KN-NaMi/Nanopositioner/electronics/amplifier/simulation/amplifier.asc

C1: cap; 1.2n
R1: res; 10k
R2: res; 220
R3: res; 30k
R4: res; 10k
R5: res; 100k
U1: OPAx197
U2: OPAx197
U3: IL300
U4: UniversalOpAmp
V1: voltage; SINE(1.5V 1.5V 1k)
V2: voltage; 15V
V3: voltage; 15V
V4: voltage; 60V
V5: voltage; 30V
V6: voltage; -2.9V
Named nets: 0, -15V, +15V, -30V, +60V, VIN
.tran 30m
