KN-NaMi/Nanopositioner/electronics/PSU/Sim/MANIP_Charge_Pump_sym.asc

C1: cap; 10�
C2: cap; 10�
C3: cap; 10n
C4: cap; 10n
C5: cap; 1�
C6: cap; 10�
C7: cap; 10�
R1: res; 1.15Meg
R2: res; 100k
R3: res; 100k
R4: res; 1.15Meg
R5: res; 500r
R6: res; 500r
U1: LTC3260
V1: voltage; 24; Rser=5
Named nets: 0, 24V, +15V, -15V
f = 500khz
const f mode
LOAD
30mA per Rail
.tran 0 10m 0 startup
