KN-NaMi/Nanopositioner/electronics/PSU/Sim/MANIP_Flyback_sym.asc

205k: res; 180k
C1: cap; 10µ
C2: cap; 1µ
C3: cap; 1n
C4: cap; 10µ
C5: cap; 10µ
C7: cap; 1µ
C8: cap; 10µ
C9: cap; 1n
D1: diode; MBRS360
D2: diode; MBRS360
D3: zener; BZX84C15L
D4: zener; BZX84C15L
L1: ind; 9µ; Rser=85m
L2: ind; 144µ; Rser=370m
L3: ind; 9µ; Rser=85m
L4: ind; 36µ; Rser=370m
R1: res; 48k
R2: res; 680k
R3: res; 1.5k
R4: res; 48k
R5: res; 115k
R6: res; 10k
R7: res; 1.5k
R8: res; 500r
R9: res; 200r
R10: res; 40r
R11: res; 680k
R12: res; 150k
R13: res; 10k
R14: res; 115k
R15: res; 40r
U1: ADPL54203
U2: ADPL54203
V1: voltage; 24; Rser=1r
Named nets: 24V, 0, +15V, -15V, +60V, 0V, -30V
K1 L1 L2  1
P=0.45W (30mA)
P=1.35W (30mA)
LOAD
1:4
UVLO at 20V (1.214V)
.tran 0 2s 0 100n startup
150mA per rail
zener 15V
140k - 60V
180k - 75V
K2 L3 L4  1
1:2
UVLO at 20V (1.214V)
750313445
750313445
