KN-NaMi/Nanopositioner/electronics/amplifier/PCB/amplifier.kicad_pcb

## KiCad design electronics/amplifier/PCB/amplifier.kicad_pcb (2026-03-23)

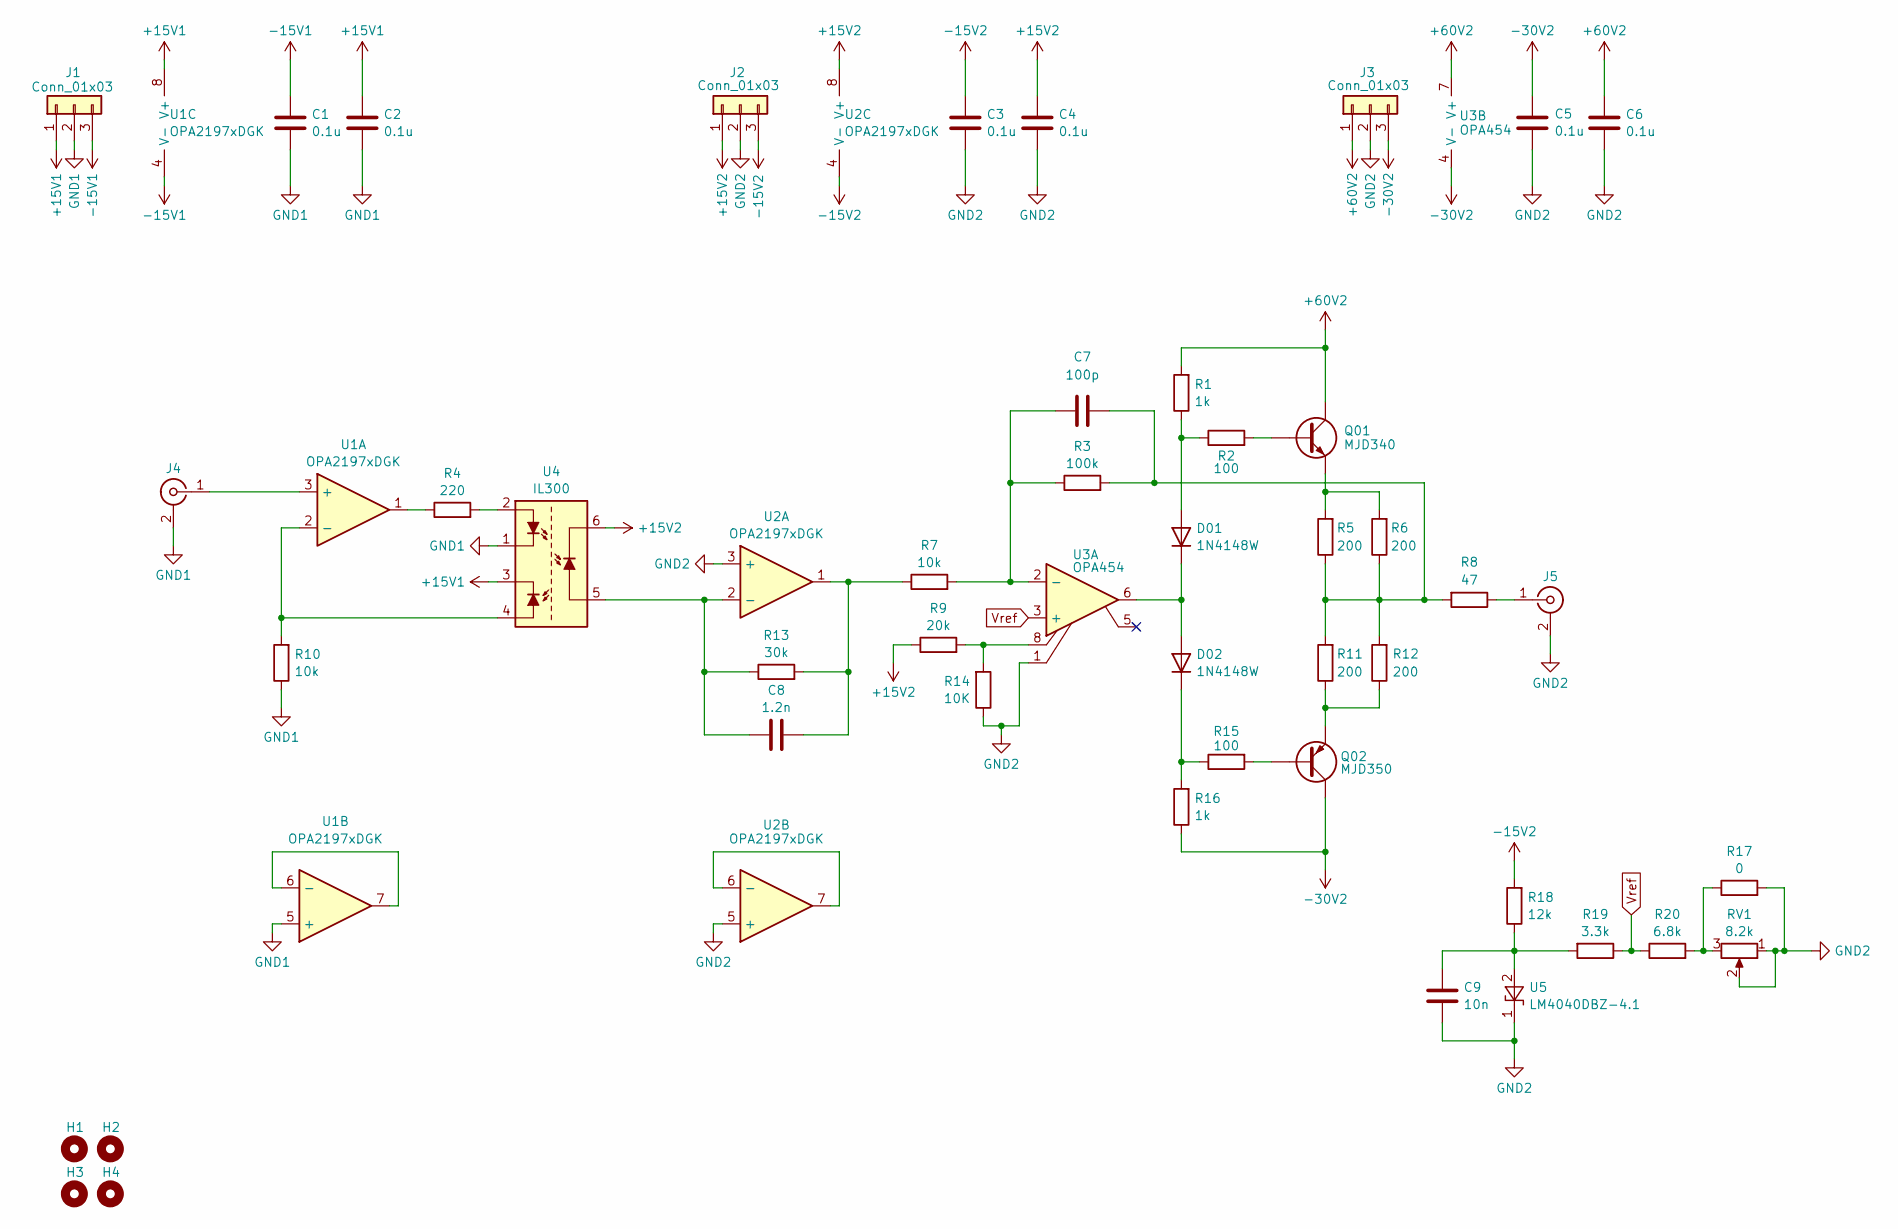
[picture p1: schematic amplifier.kicad_sch, Nanopositioner]

Parts:
C1, C2, C3, C4, C5: 0.1u; R_0603_1608Metric; Digikey 399-C0603C104K5RACTUCT-ND
C6: 0.1u; R_0603_1608Metric; Digikey 490-3285-1-ND
C7: 100p; C_0603_1608Metric; Digikey 3372-0603B101K101SDTR-ND
C8: 1.2n; C_0603_1608Metric; Digikey 490-1453-1-ND
C9: 10n; C_0603_1608Metric; Digikey 399-C0603C103K5RACTUCT-ND
D01, D02: 1N4148W; D_SOD-123; Digikey 1655-1N4148WCT-ND
H1, H2, H3, H4: MountingHole; MountingHole_3.2mm_M3_DIN965
J1, J2, J3: Conn_01x03; TerminalBlock_Phoenix_PT-1,5-3-5.0-H_1x03_P5.00mm_Horizontal; Digikey 732-10956-ND
J4, J5: Conn_Coaxial; SMA_Amphenol_132134_Vertical; Digikey 2073-RFPC-SMA28-F-ND
Q01: MJD340; TO-252-3_TabPin4; Digikey MJD340T4GOSCT-ND
Q02: MJD350; TO-252-3_TabPin4; Digikey MJD350T4GOSCT-ND
R1, R16: 1k; R_0603_1608Metric; Digikey 541-2788-1-ND
R2, R15: 100; R_0603_1608Metric; Digikey 541-2786-1-ND
R3: 100k; R_0805_2012Metric; Digikey 541-2850-1-ND
R4: 220; R_0603_1608Metric; Digikey 541-10437-1-ND
R5, R6, R11, R12: 200; R_2512_6332Metric; Digikey A116015CT-ND
R7, R10: 10k; R_0603_1608Metric; Digikey 541-2795-1-ND
R8: 47; R_2512_6332Metric; Digikey 118-CHP2512AFX-47R0ELFCT-ND
R9: 20k; R_0603_1608Metric; Digikey 541-2797-1-ND
R13: 30k; R_0603_1608Metric; Digikey 541-10453-1-ND
R14: 10K; R_0603_1608Metric; Digikey 541-2795-1-ND
R17: 0; R_0603_1608Metric
R18: 12k; R_0603_1608Metric; Digikey 541-10428-1-ND
R19: 3.3k; R_0603_1608Metric; Digikey 541-10464-1-ND
R20: 6.8k; R_0603_1608Metric; Digikey 541-10489-1-ND
RV1: 8.2k; Potentiometer_Vishay_T93YA_Vertical; Digikey 716-T63YA802KT20-ND
U1, U2: OPA2197xDGK; VSSOP-8_3x3mm_P0.65mm; Digikey 296-47349-1-ND
U3: OPA454; DDA0008J; Digikey 296-41370-1-ND
U4: IL300; SMDIP-8_W9.53mm_Clearance8mm; Digikey IL300-DEFG-X007-ND
U5: LM4040DBZ-4.1; SOT-23; Digikey LM4040AIM3-4.1/NOPBCT-ND

Connections:
+15V1: C2.1, J1.1, U1.8 (V+), U4.3
+15V2: C4.1, J2.1, R9.1, U2.8 (V+), U4.6
+60V2: C6.1, J3.1, Q01.C, R1.2, U3.7 (V+)
-15V1: C1.1, J1.3, U1.4 (V-)
-15V2: C3.1, J2.3, R18.2, U2.4 (V-)
-30V2: C5.1, J3.3, Q02.C, R16.1, U3.4 (V-)
GND1: C1.2, C2.2, J1.2, J4.2 (Ext), R10.1, U1.5 (+), U4.1
GND2: C3.2, C4.2, C5.2, C6.2, C9.1, J2.2, J3.2, J5.2 (Ext), R14.1, R17.2, RV1.1, RV1.2, U2.3 (+), U2.5 (+), U3.1, U5.1 (K)
unnamed: C7.2, R3.2, R5.1, R6.1, R8.2, R11.2, R12.2
unnamed: C8.2, R7.1, R13.2, U2.1
unnamed: D01.2 (A), R1.1, R2.1
unnamed: D01.1 (K), D02.2 (A), U3.6
unnamed: D02.1 (K), R15.1, R16.2
unnamed: J4.1 (In), U1.3 (+)
unnamed: J5.1 (In), R8.1
unnamed: Q01.B, R2.2
unnamed: Q01.E, R5.2, R6.2
unnamed: Q02.B, R15.2
unnamed: Q02.E, R11.1, R12.1
unnamed: R4.1, U1.1
unnamed: R4.2, U4.2
unnamed: R9.2, R14.2, U3.8
unnamed: R17.1, R20.2, RV1.3
unnamed: R10.2, U1.2 (-), U4.4
unnamed: U1.6 (-), U1.7
unnamed: C8.1, R13.1, U2.2 (-), U4.5
unnamed: U2.6 (-), U2.7
unnamed: C7.1, R3.1, R7.2, U3.2 (-)
unnamed: C9.2, R18.1, R19.2, U5.2 (A)
Vref: R19.1, R20.1, U3.3 (+)

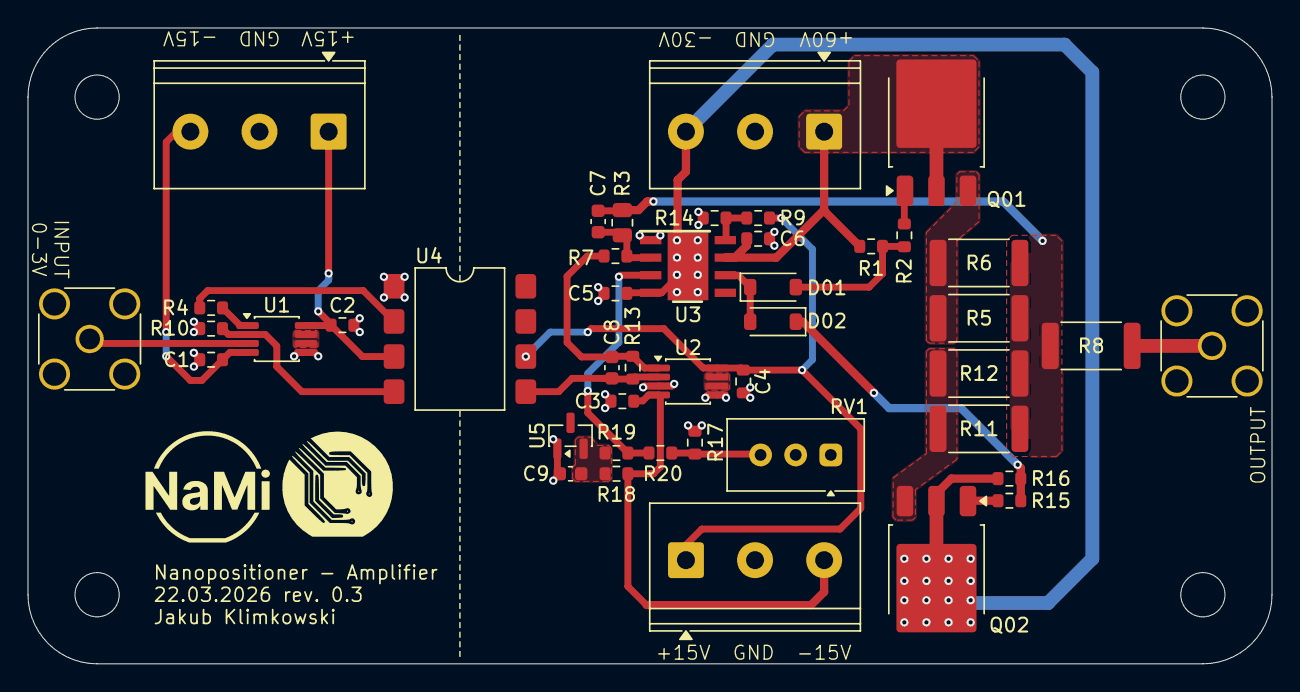
[picture p2: board amplifier.kicad_pcb from above]

Board: 2 copper layers, 90.0 x 46.0 mm, 48 parts (0 on the bottom side), 30 nets.
