KN-NaMi/Nanopositioner/electronics/PSU/pcb/psu.kicad_pcb

## KiCad design electronics/PSU/pcb/psu.kicad_pcb (2025-11-23)

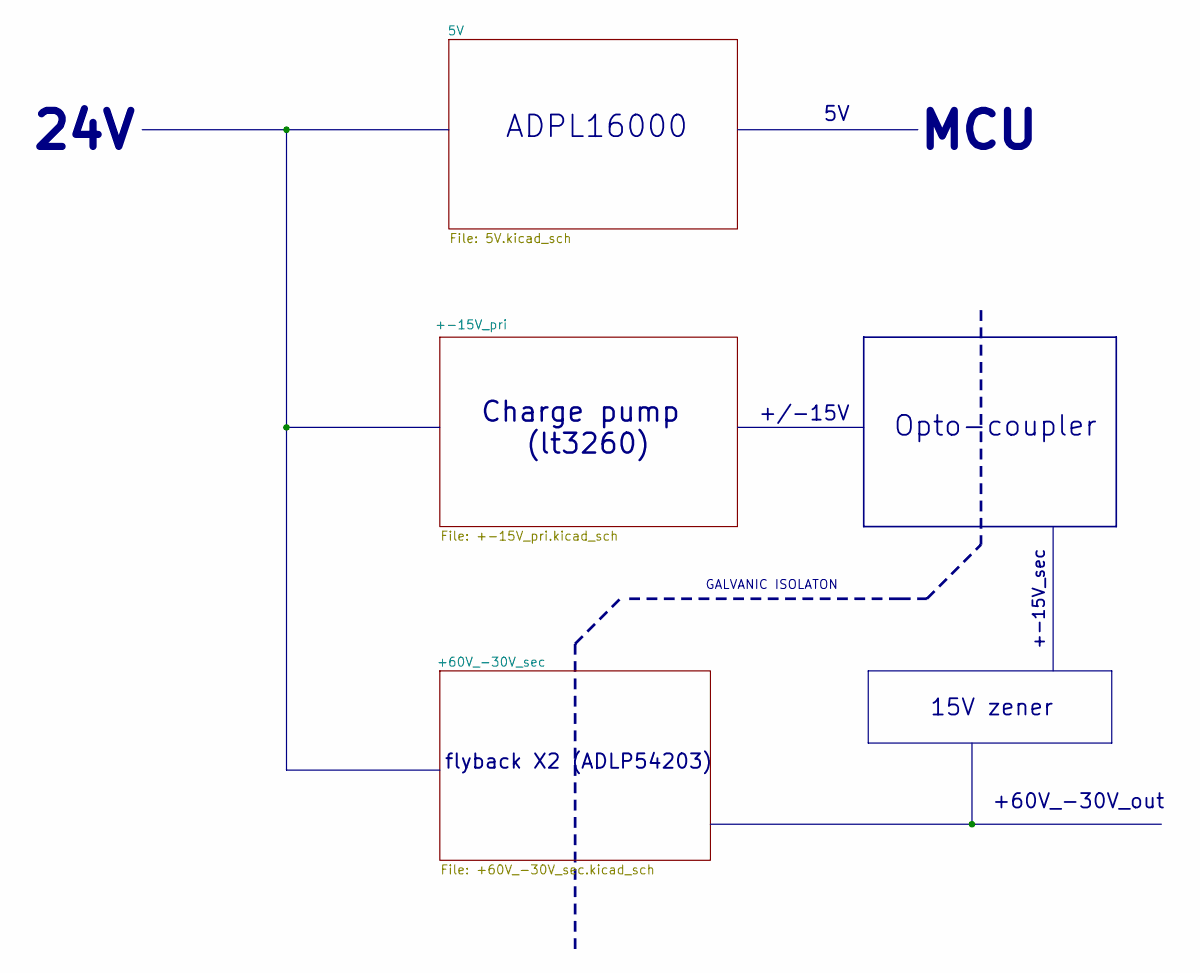
[picture p3: schematic psu.kicad_sch, MANIP_PSU]

Notes on the sheet:
MCU
+60V_-30V_out
flyback X2 (ADLP54203)
24V
ADPL16000
GALVANIC ISOLATON
+-15V_sec
+/-15V
Charge pump (lt3260)
15V zener
Opto-coupler

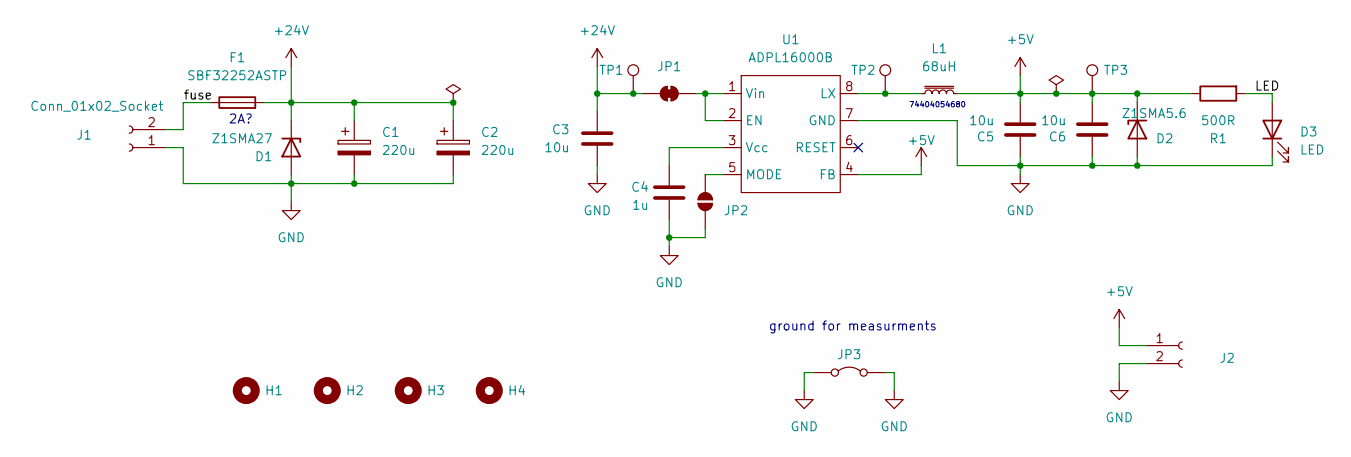
[picture p4: schematic 5V.kicad_sch, MANIP_PSU]

Parts:
C1, C2: 220u; CP_Radial_D8.0mm_P3.50mm
C3, C5, C6: 10u; C_0805_2012Metric
C4: 1u; C_0805_2012Metric
D1: Z1SMA27; D_SMA
D2: Z1SMA5.6; D_SMA
D3: LED; LED_0603_1608Metric
F1: SBF32252ASTP; Fuse_1206_3216Metric
H1, H2, H3, H4: MountingHole; MountingHole_4.3mm_M4_ISO14580
J1, J2: Conn_01x02_Socket; Wago_734-132_1x02_P3.50mm_Vertical
JP1: SolderJumper_2_Bridged; SolderJumper-2_P1.3mm_Bridged2Bar_RoundedPad1.0x1.5mm
JP2: SolderJumper_2_Open; SolderJumper-2_P1.3mm_Bridged_RoundedPad1.0x1.5mm
JP3: Jumper_2_Bridged; C_Axial_L12.0mm_D6.5mm_P20.00mm_Horizontal
L1: 68uH; L_Wuerth_MAPI-5030
R1: 500R; R_0805_2012Metric
TP1, TP2, TP3: TestPoint; TestPoint_Pad_D1.5mm
U1: ADPL16000B; ADPL16000footprint

Connections:
+5V: C5.2, C6.2, D2.1 (K), J2.1, L1.2, R1.1, TP3.1, U1.4 (FB)
+24V: C1.1, C2.1, C3.1, D1.1 (K), F1.2, JP1.1 (A), TP1.1; also elsewhere on the board
/5V/LED: D3.2 (A), R1.2
/5V/fuse: F1.1, J1.2
GND: C1.2, C2.2, C3.2, C4.2, C5.1, C6.1, D1.2 (A), D2.2 (A), D3.1 (K), J1.1, J2.2, JP2.1 (A), JP3.1 (A), JP3.2 (B), U1.7 (GND); also elsewhere on the board
unnamed: JP1.2 (B), U1.1 (Vin), U1.2 (EN)
unnamed: JP2.2 (B), U1.5 (MODE)
unnamed: L1.1, TP2.1, U1.8 (LX)
unnamed: C4.1, U1.3 (Vcc)

Notes on the sheet:
74404054680
2A?
ground for measurments

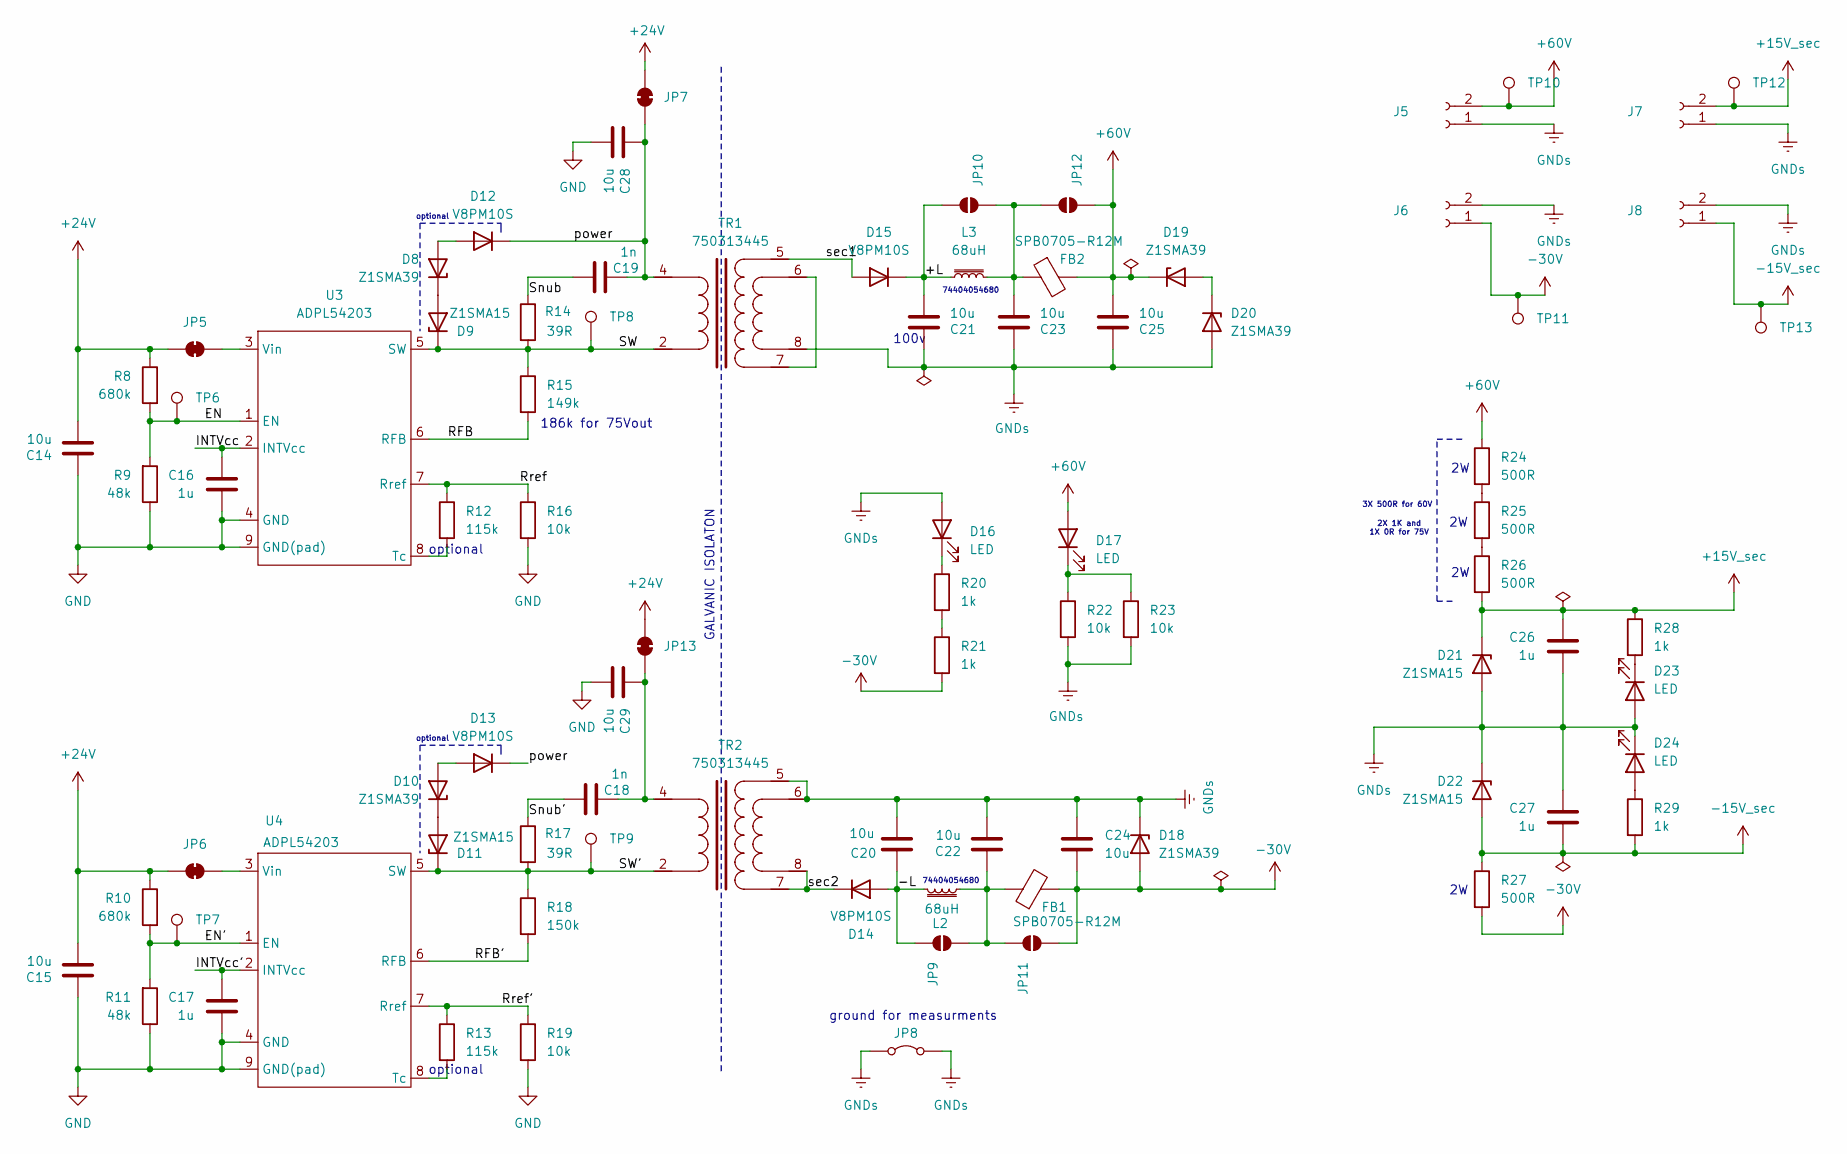
[picture p5: schematic +60V_-30V_sec.kicad_sch, MANIP_PSU]

Parts:
C14, C15, C20, C22, C24, C28, C29: 10u; C_0805_2012Metric
C16, C17, C26, C27: 1u; C_0805_2012Metric
C18, C19: 1n; C_0805_2012Metric
C21, C23, C25: 10u; C_1210_3225Metric
D8, D10, D18, D19, D20: Z1SMA39; D_SMA
D9, D11, D21, D22: Z1SMA15; D_SMA
D12, D13, D14, D15: V8PM10S; TO-277A
D16, D17, D23, D24: LED; LED_0603_1608Metric
FB1, FB2: SPB0705-R12M; L_Coilcraft_1515SQ-68N
J5, J6, J7, J8: Conn_01x02_Socket; Wago_734-132_1x02_P3.50mm_Vertical
JP5, JP6, JP7, JP13: SolderJumper_2_Bridged; SolderJumper-2_P1.3mm_Bridged2Bar_RoundedPad1.0x1.5mm
JP8: Jumper_2_Bridged; C_Axial_L12.0mm_D6.5mm_P15.00mm_Horizontal
JP9, JP10, JP11, JP12: SolderJumper_2_Open; SolderJumper-2_P1.3mm_Open_RoundedPad1.0x1.5mm
L2, L3: 68uH; L_Wuerth_MAPI-5030
R8, R10: 680k; R_0805_2012Metric
R9, R11: 48k; R_0805_2012Metric
R12, R13: 115k; R_0805_2012Metric
R14, R17: 39R; R_2512_6332Metric
R15: 149k; R_0805_2012Metric
R16, R19, R22, R23: 10k; R_0805_2012Metric
R18: 150k; R_0805_2012Metric
R20, R21, R28, R29: 1k; R_0805_2012Metric
R24, R25, R26, R27: 500R; R_2512_6332Metric
TP6, TP7, TP8, TP9, TP10, TP11, TP12, TP13: TestPoint; TestPoint_Pad_D1.5mm
TR1, TR2: 750313445
U3, U4: ADPL54203; SOIC-8-1EP_3.9x4.9mm_P1.27mm_EP2.514x3.2mm_ThermalVias

Connections:
+15V_sec: C26.1, D21.1 (K), J7.2, R26.2, R28.1, TP12.1
+24V: C14.2, C15.2, JP5.2 (B), JP6.2 (B), JP7.2 (B), JP13.1 (A), R8.1, R10.1; also elsewhere on the board
+60V: C25.2, D17.2 (A), D19.1 (K), FB2.2, J5.2, JP12.1 (A), R24.1, TP10.1
-15V_sec: C27.2, D22.2 (A), J8.1, R27.1, R29.2, TP13.1
-30V: C24.2, D18.2 (A), FB1.2, J6.1, JP11.2 (B), R21.2, R27.2, TP11.1
/+60V_-30V_sec/+L: C21.2, D15.3 (K), JP10.2 (B), L3.1
/+60V_-30V_sec/-L: C20.1, D14.1 (A), D14.2 (A), JP9.1 (A), L2.2
/+60V_-30V_sec/EN: R8.2, R9.2, TP6.1, U3.1 (EN)
/+60V_-30V_sec/EN': R10.2, R11.2, TP7.1, U4.1 (EN)
/+60V_-30V_sec/INTVcc: C16.1, U3.2 (INTVcc)
/+60V_-30V_sec/INTVcc': C17.1, U4.2 (INTVcc)
/+60V_-30V_sec/RFB: R15.2, U3.6 (RFB)
/+60V_-30V_sec/RFB': R18.2, U4.6 (RFB)
/+60V_-30V_sec/Rref: R12.1, R16.1, U3.7 (Rref)
/+60V_-30V_sec/Rref': R13.1, R19.1, U4.7 (Rref)
/+60V_-30V_sec/SW: D9.1 (K), R14.2, R15.1, TP8.1, TR1.2, U3.5 (SW)
/+60V_-30V_sec/SW': D11.1 (K), R17.2, R18.1, TP9.1, TR2.2, U4.5 (SW)
/+60V_-30V_sec/Snub: C19.1, R14.1
/+60V_-30V_sec/Snub': C18.1, R17.1
/+60V_-30V_sec/power: C19.2, C28.1, D12.3 (K), D13.3 (K), JP7.1 (A), TR1.4
/+60V_-30V_sec/sec1: D15.1 (A), D15.2 (A), TR1.5
/+60V_-30V_sec/sec2: D14.3 (K), TR2.7, TR2.8
GND: C14.1, C15.1, C16.2, C17.2, C28.2, C29.2, R9.1, R11.1, R16.2, R19.2, U3.3 (Vin), U3.4 (GND), U3.9 (GND(pad)), U4.4 (GND), U4.9 (GND(pad)); also elsewhere on the board
GNDs: C20.2, C21.1, C22.2, C23.1, C24.1, C25.1, C26.2, C27.1, D16.2 (A), D18.1 (K), D20.2 (A), D21.2 (A), D22.1 (K), D23.2 (A), D24.1 (K), J5.1, J6.2, J7.1, J8.2, JP8.1 (A), JP8.2 (B), R22.2, R23.2, TR1.8, TR2.5, TR2.6
unnamed: D8.2 (A), D12.1 (A), D12.2 (A)
unnamed: D8.1 (K), D9.2 (A)
unnamed: D10.2 (A), D13.1 (A), D13.2 (A)
unnamed: D10.1 (K), D11.2 (A)
unnamed: D16.1 (K), R20.1
unnamed: D17.1 (K), R22.1, R23.1
unnamed: D19.2 (A), D20.1 (K)
unnamed: D23.1 (K), R28.2
unnamed: D24.2 (A), R29.1
unnamed: JP5.1 (A), U3.3 (Vin)
unnamed: JP6.1 (A), U4.3 (Vin)
unnamed: C23.2, FB2.1, JP10.1 (A), JP12.2 (B), L3.2
unnamed: C22.1, FB1.1, JP9.2 (B), JP11.1 (A), L2.1
unnamed: C18.2, C29.1, JP13.2 (B), TR2.4
unnamed: R20.2, R21.1
unnamed: R24.2, R25.1
unnamed: R25.2, R26.1
unnamed: TR1.6, TR1.7
unnamed: R12.2, U3.8 (Tc)
unnamed: R13.2, U4.8 (Tc)

Notes on the sheet:
optional
74404054680
3X 500R for 60V
GALVANIC ISOLATON
2X 1K and 1X 0R for 75V
100v
ground for measurments
186k for 75Vout

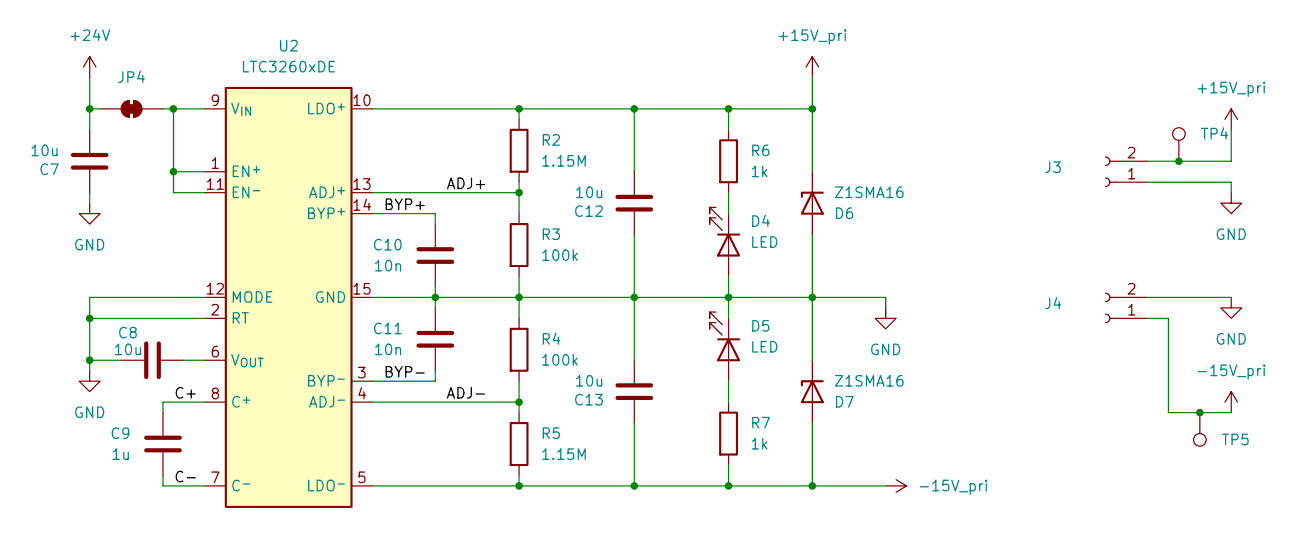
[picture p6: schematic +-15V_pri.kicad_sch, MANIP_PSU]

Parts:
C7, C8, C12, C13: 10u; C_0805_2012Metric
C9: 1u; C_0805_2012Metric
C10, C11: 10n; C_0805_2012Metric
D4, D5: LED; LED_0603_1608Metric
D6, D7: Z1SMA16; D_SMA
J3, J4: Conn_01x02_Socket; Wago_734-132_1x02_P3.50mm_Vertical
JP4: SolderJumper_2_Bridged; SolderJumper-2_P1.3mm_Bridged2Bar_RoundedPad1.0x1.5mm
R2, R5: 1.15M; R_0805_2012Metric
R3, R4: 100k; R_0805_2012Metric
R6, R7: 1k; R_0805_2012Metric
TP4, TP5: TestPoint; TestPoint_Pad_D1.5mm
U2: LTC3260xDE; DFN-14-1EP_3x4mm_P0.5mm_EP1.7x3.3mm

Connections:
+15V_pri: C12.2, D6.1 (K), J3.2, R2.1, R6.1, TP4.1, U2.10 (LDO^{+})
+24V: C7.2, JP4.1 (A); also elsewhere on the board
-15V_pri: C13.1, D7.2 (A), J4.1, R5.2, R7.2, TP5.1, U2.5 (LDO^{-})
/+-15V_pri/ADJ+: R2.2, R3.1, U2.13 (ADJ^{+})
/+-15V_pri/ADJ-: R4.2, R5.1, U2.4 (ADJ^{-})
/+-15V_pri/BYP+: C10.1, U2.14 (BYP^{+})
/+-15V_pri/BYP-: C11.2, U2.3 (BYP^{-})
/+-15V_pri/C+: C9.1, U2.8 (C^{+})
/+-15V_pri/C-: C9.2, U2.7 (C^{-})
GND: C7.1, C8.2, C10.2, C11.1, C12.1, C13.2, D4.2 (A), D5.1 (K), D6.2 (A), D7.1 (K), J3.1, J4.2, R3.2, R4.1, U2.2 (RT), U2.12 (MODE), U2.15 (GND); also elsewhere on the board
unnamed: D4.1 (K), R6.2
unnamed: D5.2 (A), R7.1
unnamed: JP4.2 (B), U2.1 (EN^{+}), U2.9 (V_{IN}), U2.11 (EN^{-})
unnamed: C8.1, U2.6 (V_{OUT})

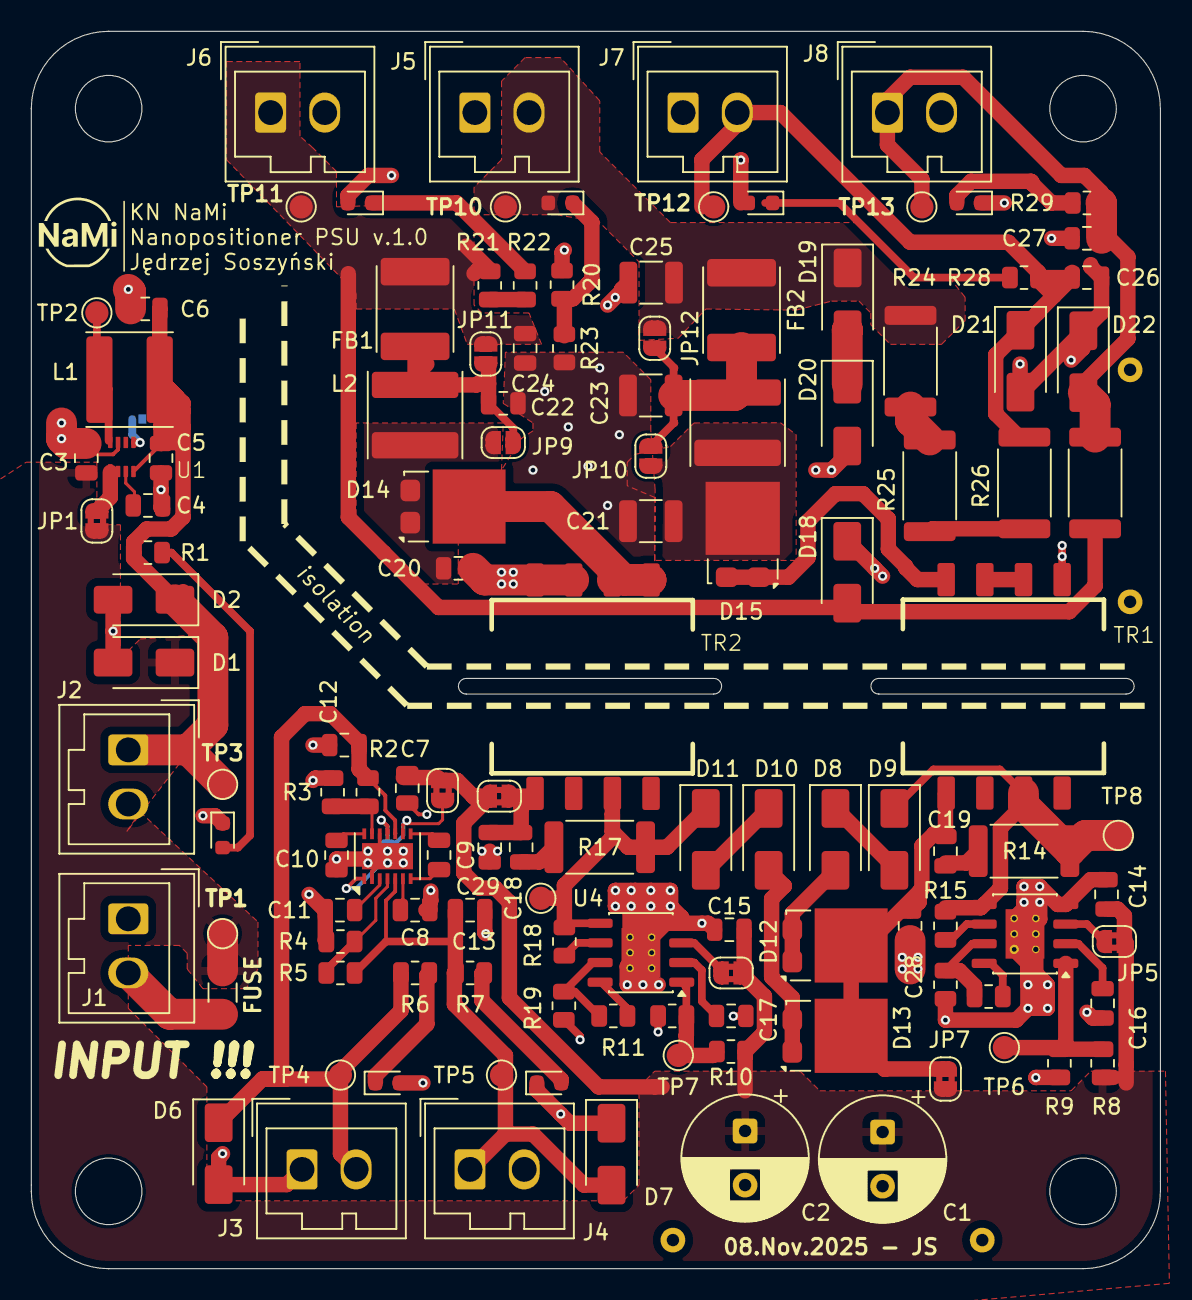
[picture p7: board psu.kicad_pcb from above]

Board: 2 copper layers, 73.0 x 80.0 mm, 132 parts (1 on the bottom side), 63 nets.
