KN-NaMi/Nanopositioner/(commit log)

2025-05-25 add amplifier sch
    [amplifier.kicad_pcb, amplifier.kicad_sch]
2025-05-27 change to inverting opamp configuration
    [amplifier.kicad_sch]
2025-10-26 Schemat PSU + symulacje PSU
    [+-15V_pri.kicad_sch, +60V_-30V_sec.kicad_sch, 5V.kicad_sch, Nanopozycjoner_Power_Supply.kicad_pcb, Nanopozycjoner_Power_Supply.kicad_sch]
2025-10-27 poprawki do schematu psu
    [+-15V_pri.kicad_sch, +60V_-30V_sec.kicad_sch, 5V.kicad_sch, Nanopozycjoner_Power_Supply.kicad_sch]
2025-11-09 added PSU PCB design files
    [+-15V_pri.kicad_sch, +60V_-30V_sec.kicad_sch, 5V.kicad_sch, Nanopozycjoner_Power_Supply.csv, Nanopozycjoner_Power_Supply.kicad_sch, Nanopozycjoner_Power_Supply.xlsx]
2025-11-12 final changes
    [+-15V_pri.kicad_sch, 5V.kicad_sch, Nanopozycjoner_Power_Supply.kicad_pcb]
2025-11-17 restructured repo according to the template
    [+-15V_pri.kicad_sch, +60V_-30V_sec.kicad_sch, 5V.kicad_sch, Nanopozycjoner_Power_Supply.csv, Nanopozycjoner_Power_Supply.kicad_pcb, Nanopozycjoner_Power_Supply.kicad_sch, Nanopozycjoner_Power_Supply.xlsx, amplifier.kicad_pcb]
2025-11-17 Refactor repo
    [+-15V_pri.kicad_sch, +60V_-30V_sec.kicad_sch, 5V.kicad_sch, psu.csv, psu.kicad_pcb, psu.kicad_sch, psu.xlsx]
2025-11-23 update pcb signature
    [psu.kicad_pcb]
2026-03-23 feat: amplifier board rev. 03
    [amplifier.kicad_pcb, amplifier.kicad_sch]
